guitarrista672f/graphite-system/iniciales backup/graphite_spireflows/kidkad_projects/project1/circuito_led/report.txt

Annotated +24V as #PWR01
Annotated GND as #PWR02
Annotated 400 as C1
Annotated LED as D1
Annotated 1000 as R1
Annotated L7805 as U1
