guitarrista672f/graphite-system/iniciales backup/arduino_grafito/arduino_graphite/arduino_graphite.jpg

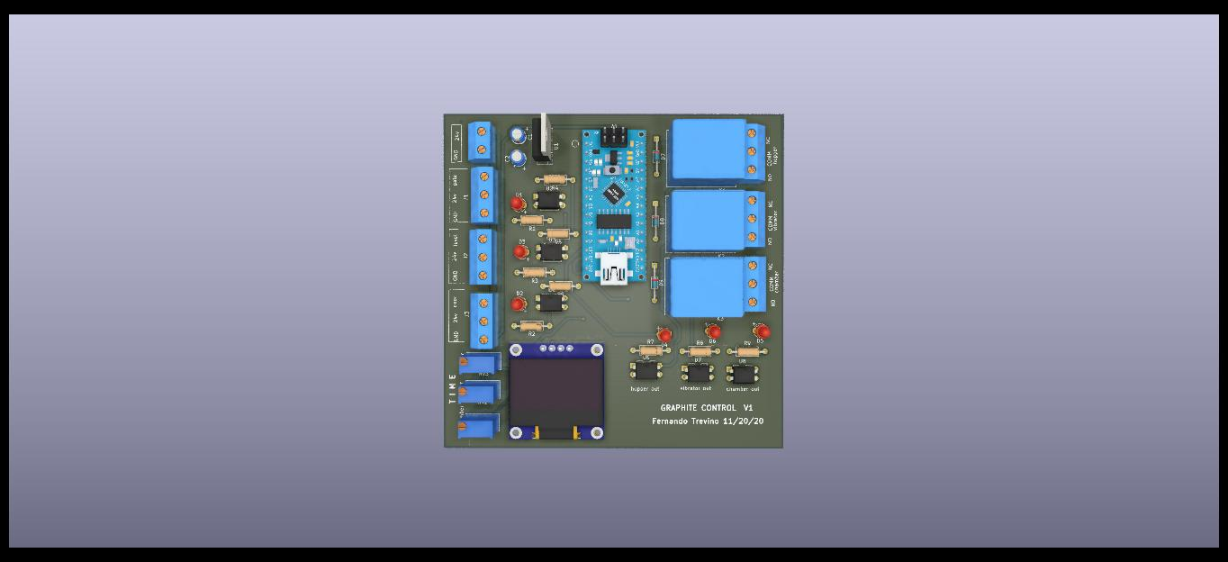
iniciales backup/arduino_grafito/arduino_graphite/arduino_graphite.jpg
