guitarrista672f/graphite-system/iniciales backup/graphite_spireflows/graphite pictures/20200905_205842.jpg

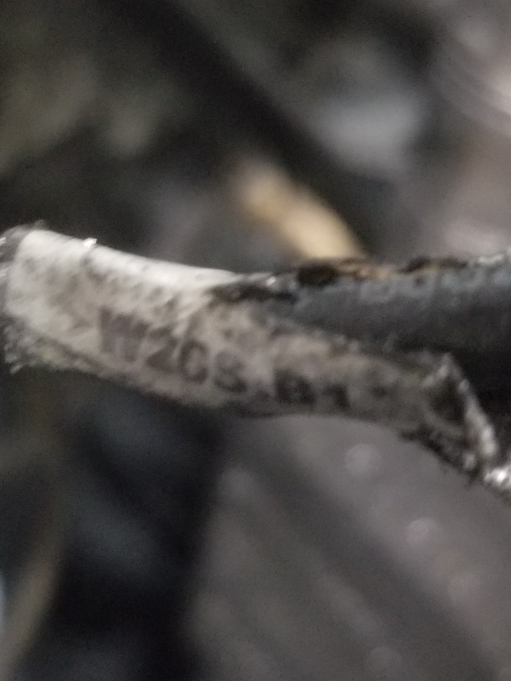
iniciales backup/graphite_spireflows/graphite pictures/20200905_205842.jpg
