guitarrista672f/graphite-system/iniciales backup/graphite_spireflows/graphite pictures/20201205_213206.jpg

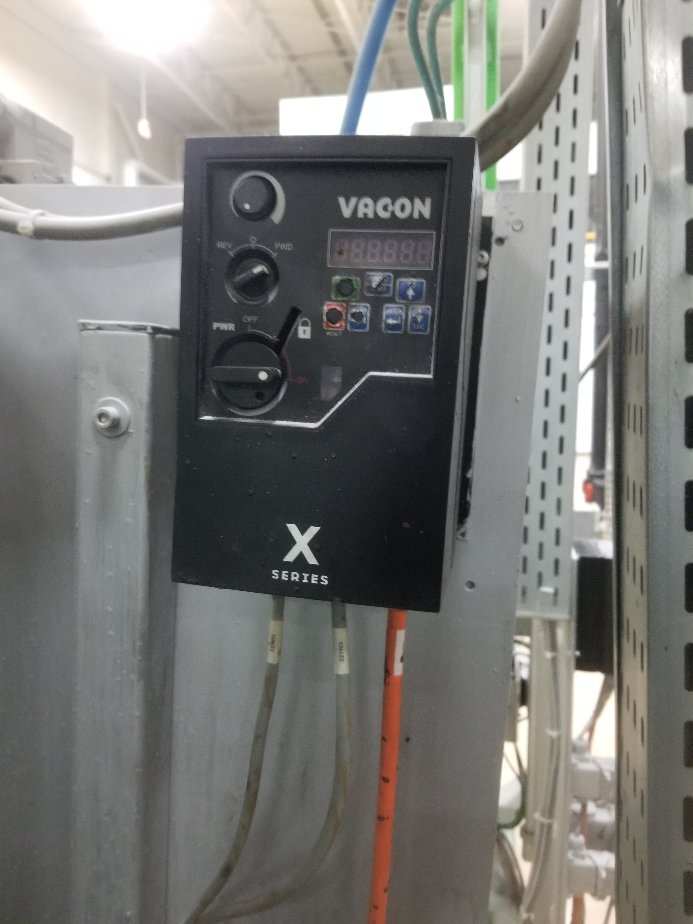
iniciales backup/graphite_spireflows/graphite pictures/20201205_213206.jpg
