guitarrista672f/graphite-system/iniciales backup/graphite_spireflows/graphite pictures/20201207_012839.jpg

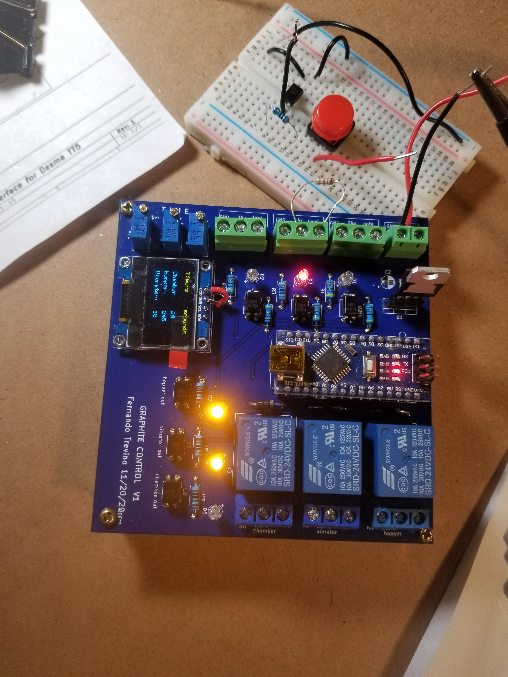
iniciales backup/graphite_spireflows/graphite pictures/20201207_012839.jpg
