guitarrista672f/graphite-system/iniciales backup/graphite_spireflows/graphite pictures/20201207_012943.jpg

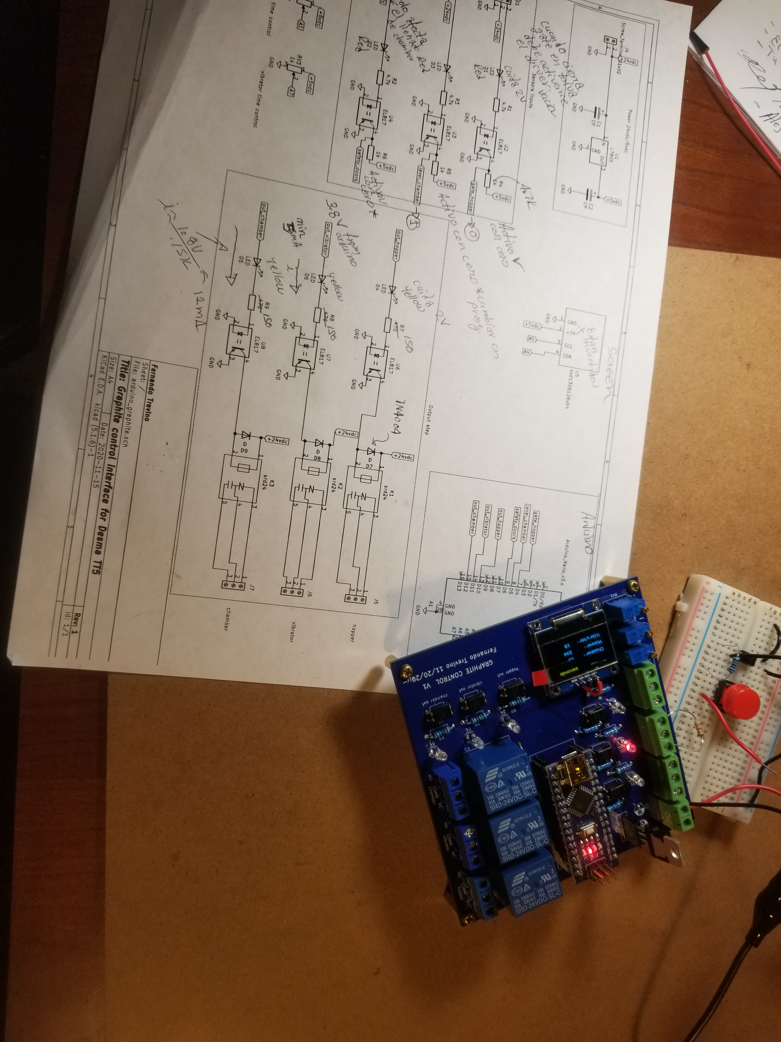
iniciales backup/graphite_spireflows/graphite pictures/20201207_012943.jpg
