guitarrista672f/graphite-system/iniciales backup/graphite_spireflows/graphite pictures/20201209_202442.jpg

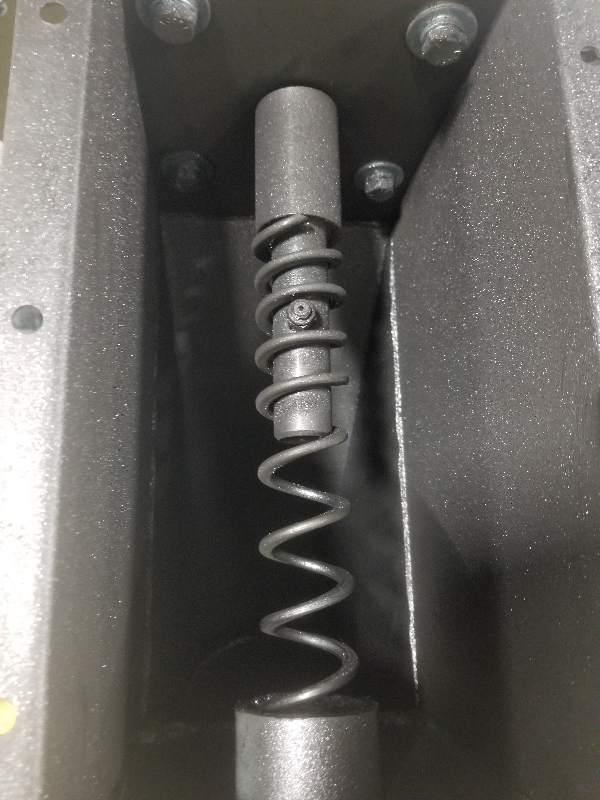
iniciales backup/graphite_spireflows/graphite pictures/20201209_202442.jpg
