guitarrista672f/graphite-system/iniciales backup/graphite_spireflows/graphite pictures/20201214_152126.jpg

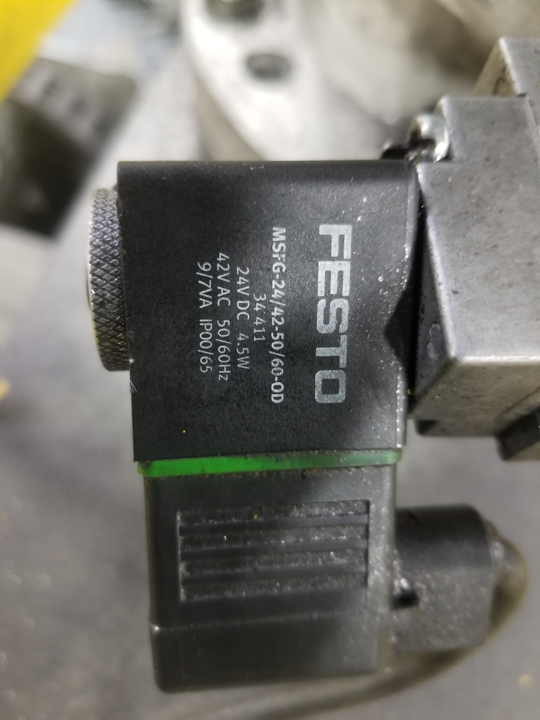
iniciales backup/graphite_spireflows/graphite pictures/20201214_152126.jpg
