guitarrista672f/graphite-system/iniciales backup/graphite_spireflows/graphite pictures/20201214_152921.jpg

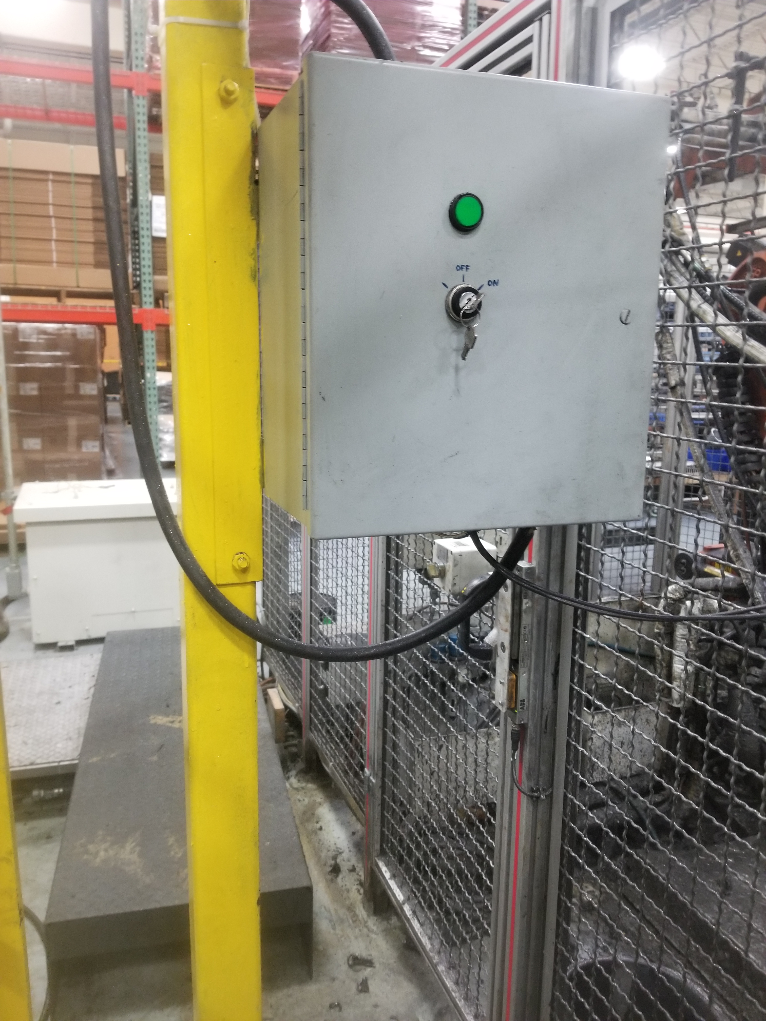
iniciales backup/graphite_spireflows/graphite pictures/20201214_152921.jpg
