guitarrista672f/graphite-system/iniciales backup/graphite_spireflows/graphite pictures/20201215_221558.jpg

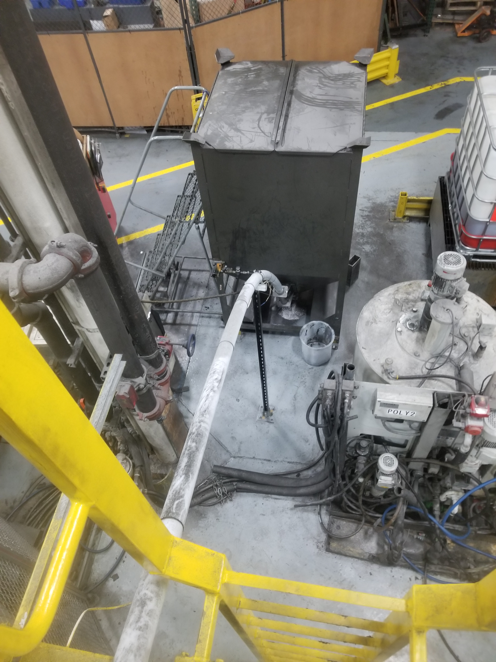
iniciales backup/graphite_spireflows/graphite pictures/20201215_221558.jpg
