guitarrista672f/graphite-system/iniciales backup/graphite_spireflows/control_digital_circuit_pcboard_disign/control_digital.kicad_pcb

## KiCad design iniciales backup/graphite_spireflows/control_digital_circuit_pcboard_disign/control_digital.kicad_pcb (2024-02-02)

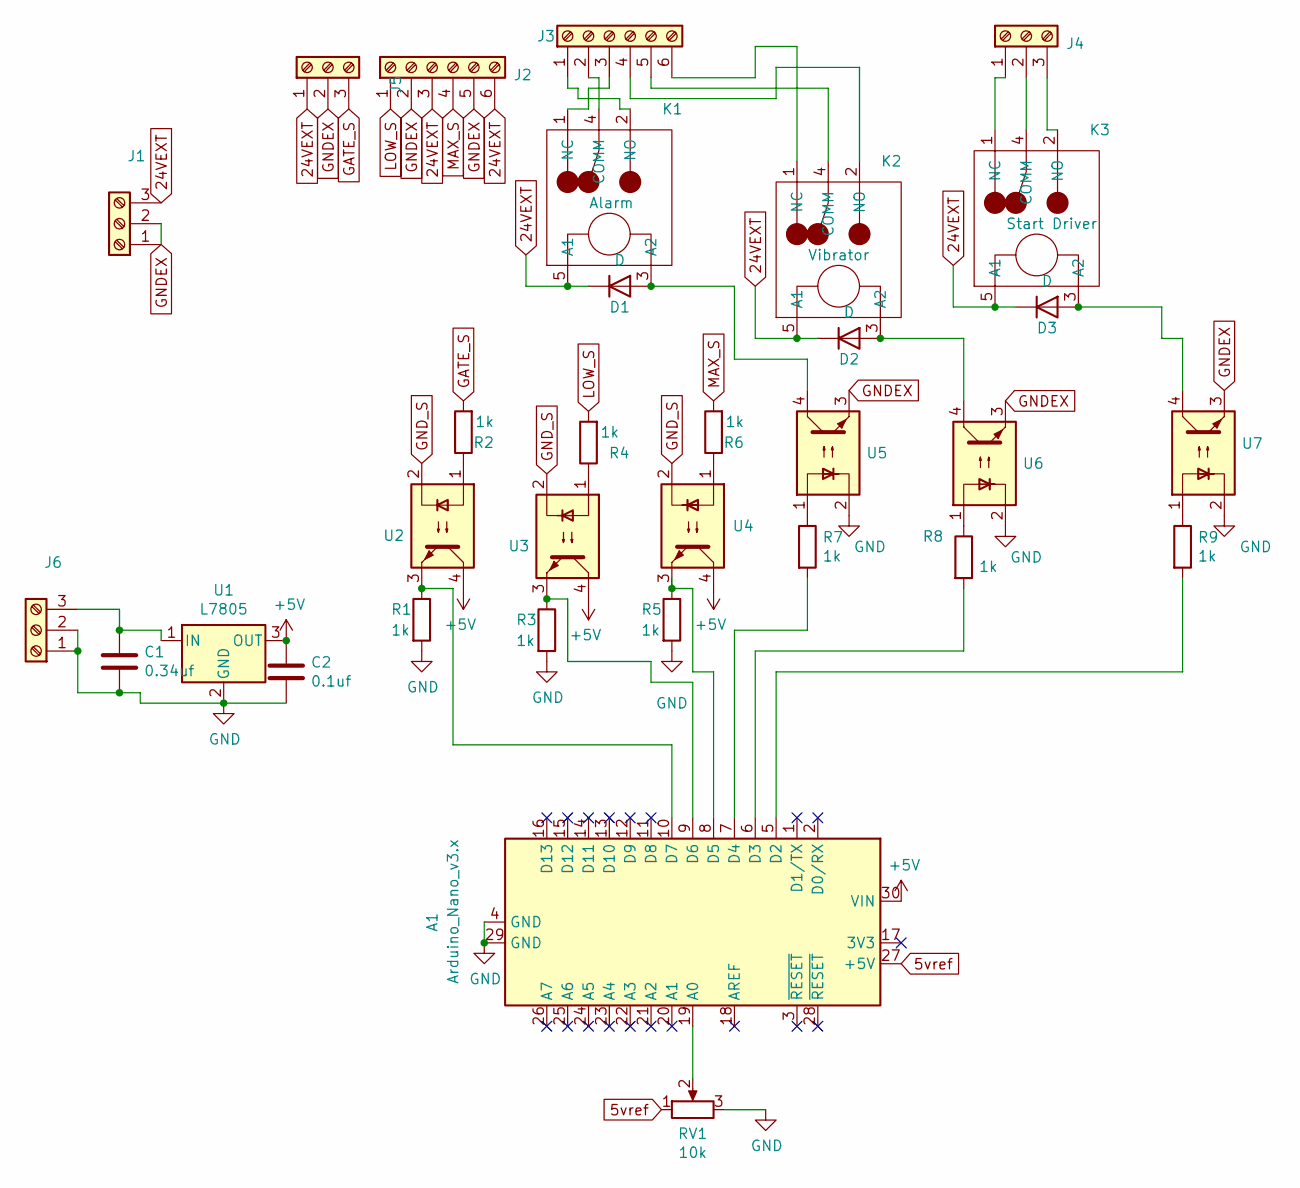
[picture p32: schematic control_digital.kicad_sch, Digital control for graphite system]

Parts:
A1: Arduino_Nano_v3.x; Arduino_Nano
C1: 0.34uf; CP_Radial_D6.3mm_P2.50mm
C2: 0.1uf; CP_Radial_D6.3mm_P2.50mm
D1, D2, D3: D; D_A-405_P7.62mm_Horizontal
J1, J4, J5, J6: Screw_Terminal_01x03; TerminalBlock_bornier-3_P5.08mm
J2, J3: Screw_Terminal_01x06; TerminalBlock_bornier-6_P5.08mm
K1: Alarm; SRD-24VDC-SL-C
K2: Vibrator; SRD-24VDC-SL-C
K3: Start Driver; SRD-24VDC-SL-C
R1, R2, R3, R4, R5, R6, R7, R8, R9: 1k; R_Axial_DIN0309_L9.0mm_D3.2mm_P12.70mm_Horizontal
RV1: 10k; pot_f
U1: L7805; Regulator7805
U2: SFH617A-2X016; DIP-4_W7.62mm
U3, U4, U5, U6, U7: SFH617A-2X016; DIP-4_W10.16mm

Connections:
5vref: A1.27 (+5V), RV1.1; also elsewhere on the board
24VEXT: D1.1 (K), D2.1 (K), D3.1 (K), J1.3, J2.3, J2.6, J5.1, K1.5 (A1), K2.5 (A1), K3.5 (A1)
+5V: A1.30 (VIN), C2.1, U1.3 (OUT), U2.4, U3.4, U4.4
GATE_S: J5.3, R2.2
GND: A1.4 (GND), A1.29 (GND), C1.2, C2.2, J6.1, J6.2, R1.2, R3.2, R5.2, RV1.3, U1.2 (GND), U5.2, U6.2, U7.2; also elsewhere on the board
GNDEX: J1.1, J1.2, J2.2, J2.5, J5.2, U5.3, U6.3, U7.3
GND_S: U2.2, U3.2, U4.2
LOW_S: J2.1, R4.2
MAX_S: J2.4, R6.2
unnamed: A1.5 (D2), R9.2
unnamed: A1.6 (D3), R8.2
unnamed: A1.7 (D4), R7.2
unnamed: A1.8 (D5), R5.1, U4.3
unnamed: A1.9 (D6), R3.1, U3.3
unnamed: A1.10 (D7), R1.1, U2.3
unnamed 15: A1.19 (A0), RV1.2; also elsewhere on the board
unnamed: C1.1, J6.3, U1.1 (IN)
unnamed: D1.2 (A), K1.3 (A2), U5.4
unnamed: D2.2 (A), K2.3 (A2), U6.4
unnamed: D3.2 (A), K3.3 (A2), U7.4
unnamed: J3.1, K1.2 (NO)
unnamed: J3.2, K1.4 (COMM)
unnamed: J3.3, K1.1 (NC)
unnamed: J3.4, K2.2 (NO)
unnamed: J3.5, K2.4 (COMM)
unnamed: J3.6, K2.1 (NC)
unnamed: J4.1, K3.1 (NC)
unnamed: J4.2, K3.4 (COMM)
unnamed: J4.3, K3.2 (NO)
unnamed: R2.1, U2.1
unnamed: R4.1, U3.1
unnamed: R6.1, U4.1
unnamed: R7.1, U5.1
unnamed: R8.1, U6.1
unnamed: R9.1, U7.1

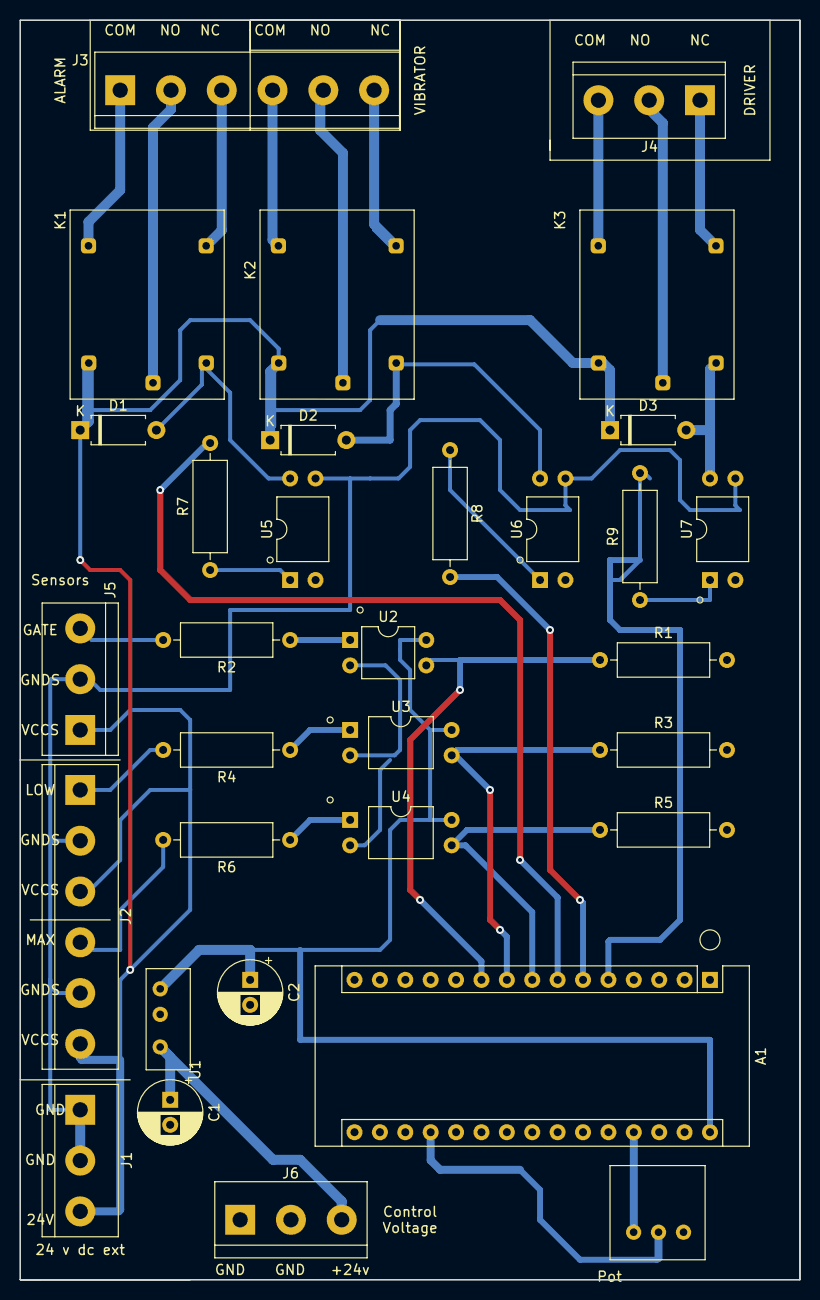
[picture p33: board control_digital.kicad_pcb from above]

Board: 2 copper layers, 78.0 x 126.0 mm, 32 parts (0 on the bottom side), 35 nets.

Other parts of the board:
Pot: 10k; pot_f

Their connections:
5vref: Pot.1; also elsewhere on the board
GND: Pot.3; also elsewhere on the board
unnamed 15: Pot.2; also elsewhere on the board
