guitarrista672f/graphite-system/iniciales backup/graphite_spireflows/kidkad_projects/project1/circuito_led/circuito_led.kicad_pcb

## KiCad design iniciales backup/graphite_spireflows/kidkad_projects/project1/circuito_led/circuito_led.kicad_pcb (2024-02-02)

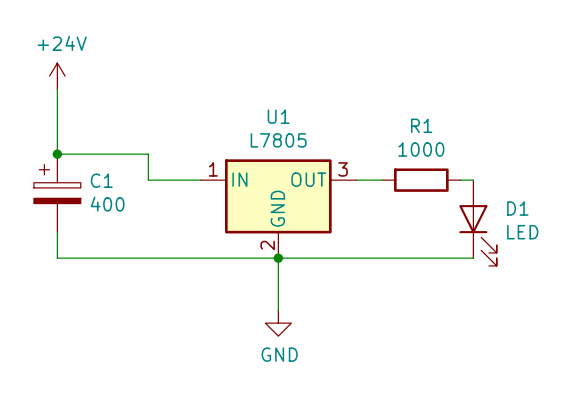
[picture p34: schematic circuito_led.sch]

Parts:
C1: 400; CP_Radial_D10.0mm_P3.50mm
D1: LED; LED_Oval_W5.2mm_H3.8mm
R1: 1000; R_Radial_Power_L16.1mm_W9.0mm_P7.37mm
U1: L7805; TO-220-3_Vertical

Connections:
+24V: C1.1, U1.1 (IN)
GND: C1.2, D1.1 (K), U1.2 (GND)
unnamed: D1.2 (A), R1.1
unnamed: R1.2, U1.3 (OUT)

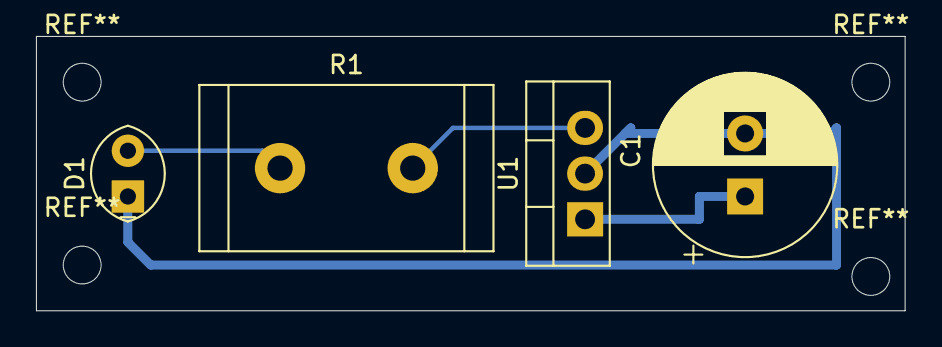
[picture p35: board circuito_led.kicad_pcb from above]

Board: 2 copper layers, 48.3 x 15.2 mm, 4 parts (0 on the bottom side), 4 nets.
