guitarrista672f/graphite-system/iniciales backup/arduino_grafito/arduino_graphite/arduino_graphite.kicad_pcb

## KiCad design iniciales backup/arduino_grafito/arduino_graphite/arduino_graphite.kicad_pcb (2024-02-02)

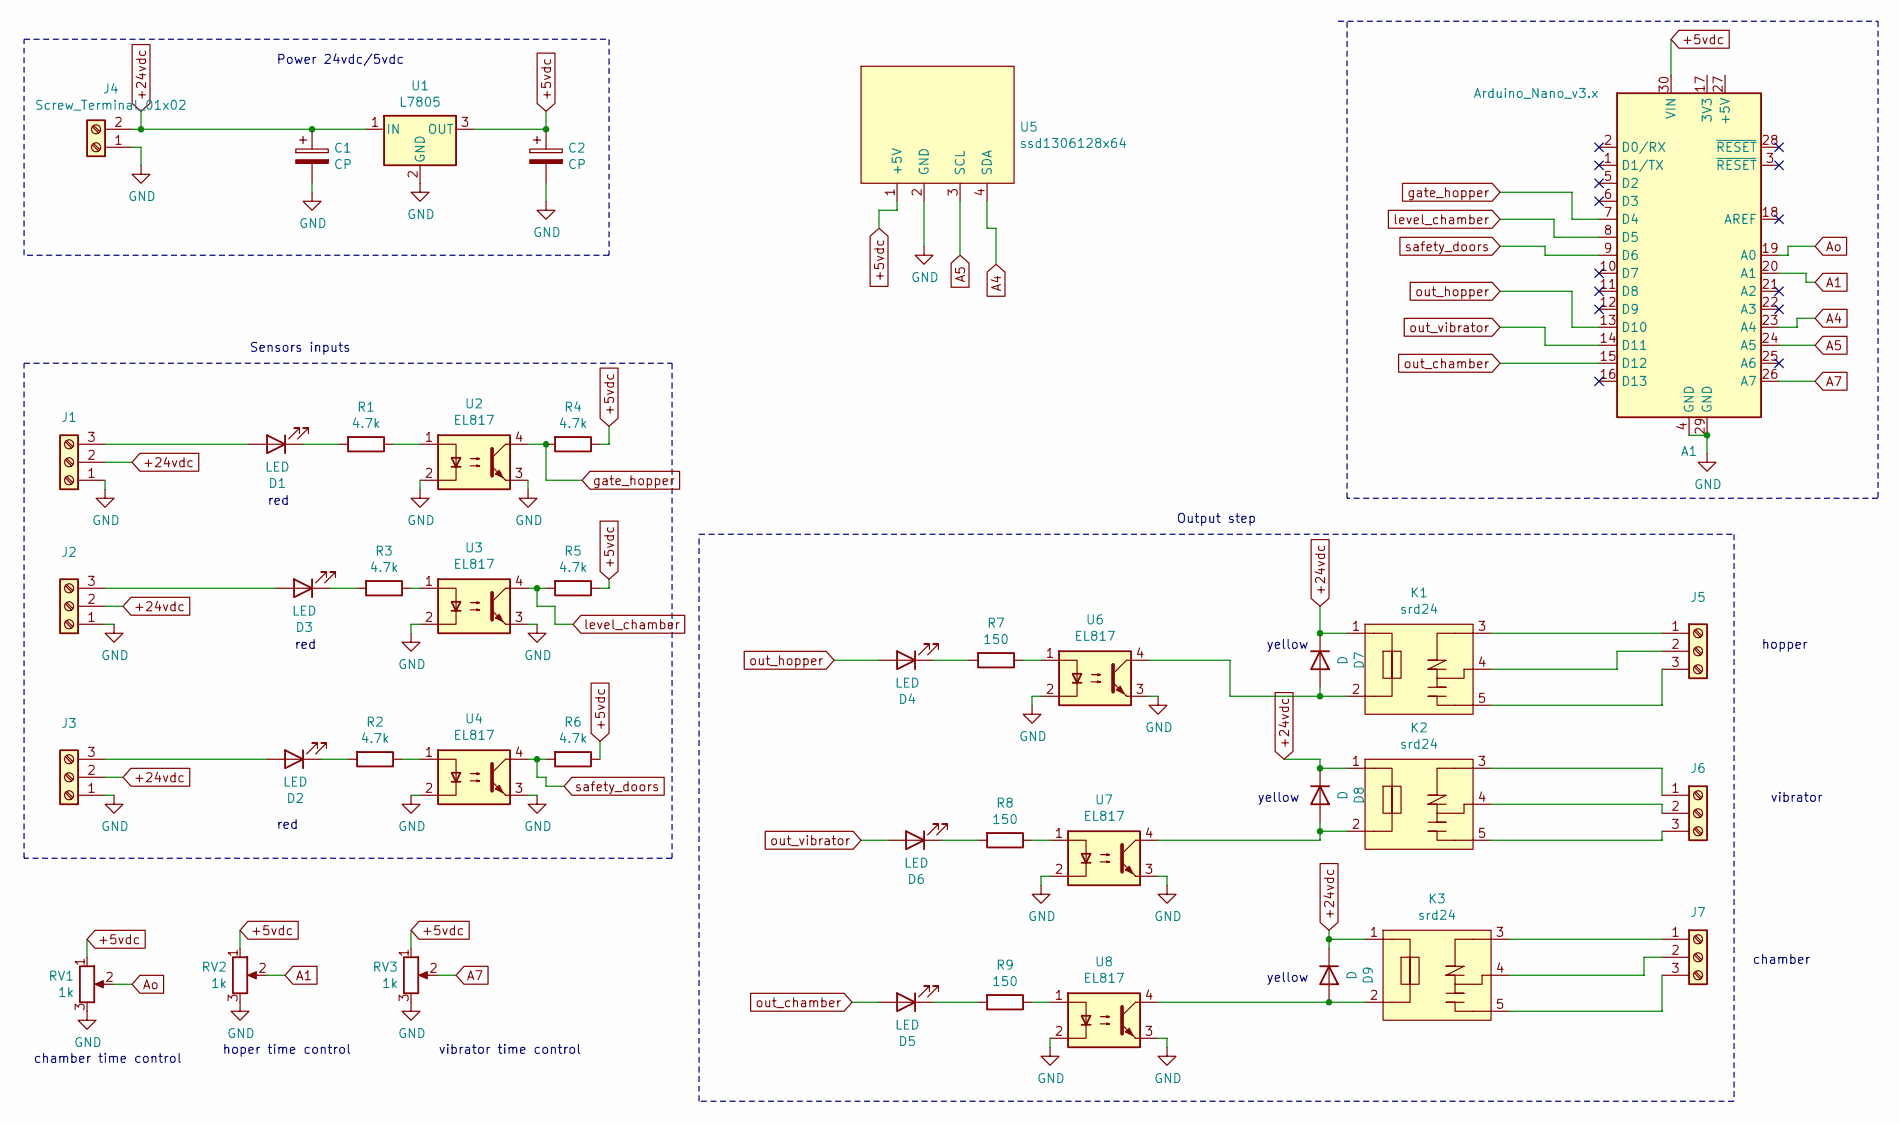
[picture p36: schematic arduino_graphite.sch, Graphite control interface for Desma TT5]

Parts:
A1: Arduino_Nano_v3.x; Arduino_Nano
C1, C2: CP; capacitor
D1, D2, D3, D4, D5, D6: LED; led
D7, D8, D9: D; diode
J1, J2, J3, J5, J6, J7: Screw_Terminal_01x03; TerminalBlock_Altech_AK300-3_P5.00mm
J4: Screw_Terminal_01x02; TerminalBlock_Altech_AK300-2_P5.00mm
K1, K2, K3: srd24
R1, R2, R3, R4, R5, R6: 4.7k; resistor
R7, R8, R9: 150; resistor
RV1, RV2, RV3: 1k; potensiometro
U1: L7805; 7805
U2, U3, U4, U6, U7, U8: EL817; DIP-4_W7.62mm
U5: ssd1306128x64

Connections:
+5vdc: A1.30 (VIN), C2.1, R4.1, R5.1, R6.1, RV1.1, RV2.1, RV3.1, U1.3 (OUT), U5.1 (+5V)
+24vdc: C1.1, D7.1 (K), D8.1 (K), D9.1 (K), J1.2, J2.2, J3.2, J4.2, K1.1, K2.1, K3.1, U1.1 (IN)
A1: A1.20 (A1), RV2.2
A4: A1.23 (A4), U5.4 (SDA)
A5: A1.24 (A5), U5.3 (SCL)
A7: A1.26 (A7), RV3.2
Ao: A1.19 (A0), RV1.2
GND: A1.4 (GND), A1.29 (GND), C1.2, C2.2, J1.1, J2.1, J3.1, J4.1, RV1.3, RV2.3, RV3.3, U1.2 (GND), U2.2, U2.3, U3.2, U3.3, U4.2, U4.3, U5.2 (GND), U6.2, U6.3, U7.2, U7.3, U8.2, U8.3
unnamed: D1.1 (K), R1.2
unnamed: D1.2 (A), J1.3
unnamed: D2.1 (K), R2.2
unnamed: D2.2 (A), J3.3
unnamed: D3.1 (K), R3.2
unnamed: D3.2 (A), J2.3
unnamed: D4.1 (K), R7.2
unnamed: D5.1 (K), R9.2
unnamed: D6.1 (K), R8.2
unnamed: D7.2 (A), K1.2, U6.4
unnamed: D8.2 (A), K2.2, U7.4
unnamed: D9.2 (A), K3.2, U8.4
unnamed: J5.1, K1.3
unnamed: J5.2, K1.4
unnamed: J5.3, K1.5
unnamed: J6.1, K2.3
unnamed: J6.2, K2.4
unnamed: J6.3, K2.5
unnamed: J7.1, K3.3
unnamed: J7.2, K3.4
unnamed: J7.3, K3.5
unnamed: R1.1, U2.1
unnamed: R2.1, U4.1
unnamed: R3.1, U3.1
unnamed: R7.1, U6.1
unnamed: R8.1, U7.1
unnamed: R9.1, U8.1
gate_hopper: A1.7 (D4), R4.2, U2.4
level_chamber: A1.8 (D5), R5.2, U3.4
out_chamber: A1.15 (D12), D5.2 (A)
out_hopper: A1.13 (D10), D4.2 (A)
out_vibrator: A1.14 (D11), D6.2 (A)
safety_doors: A1.9 (D6), R6.2, U4.4

Notes on the sheet:
Output step
Power 24vdc/5vdc
Sensors inputs
hopper
vibrator
chamber
chamber time control
hoper time control
vibrator time control
yellow
red

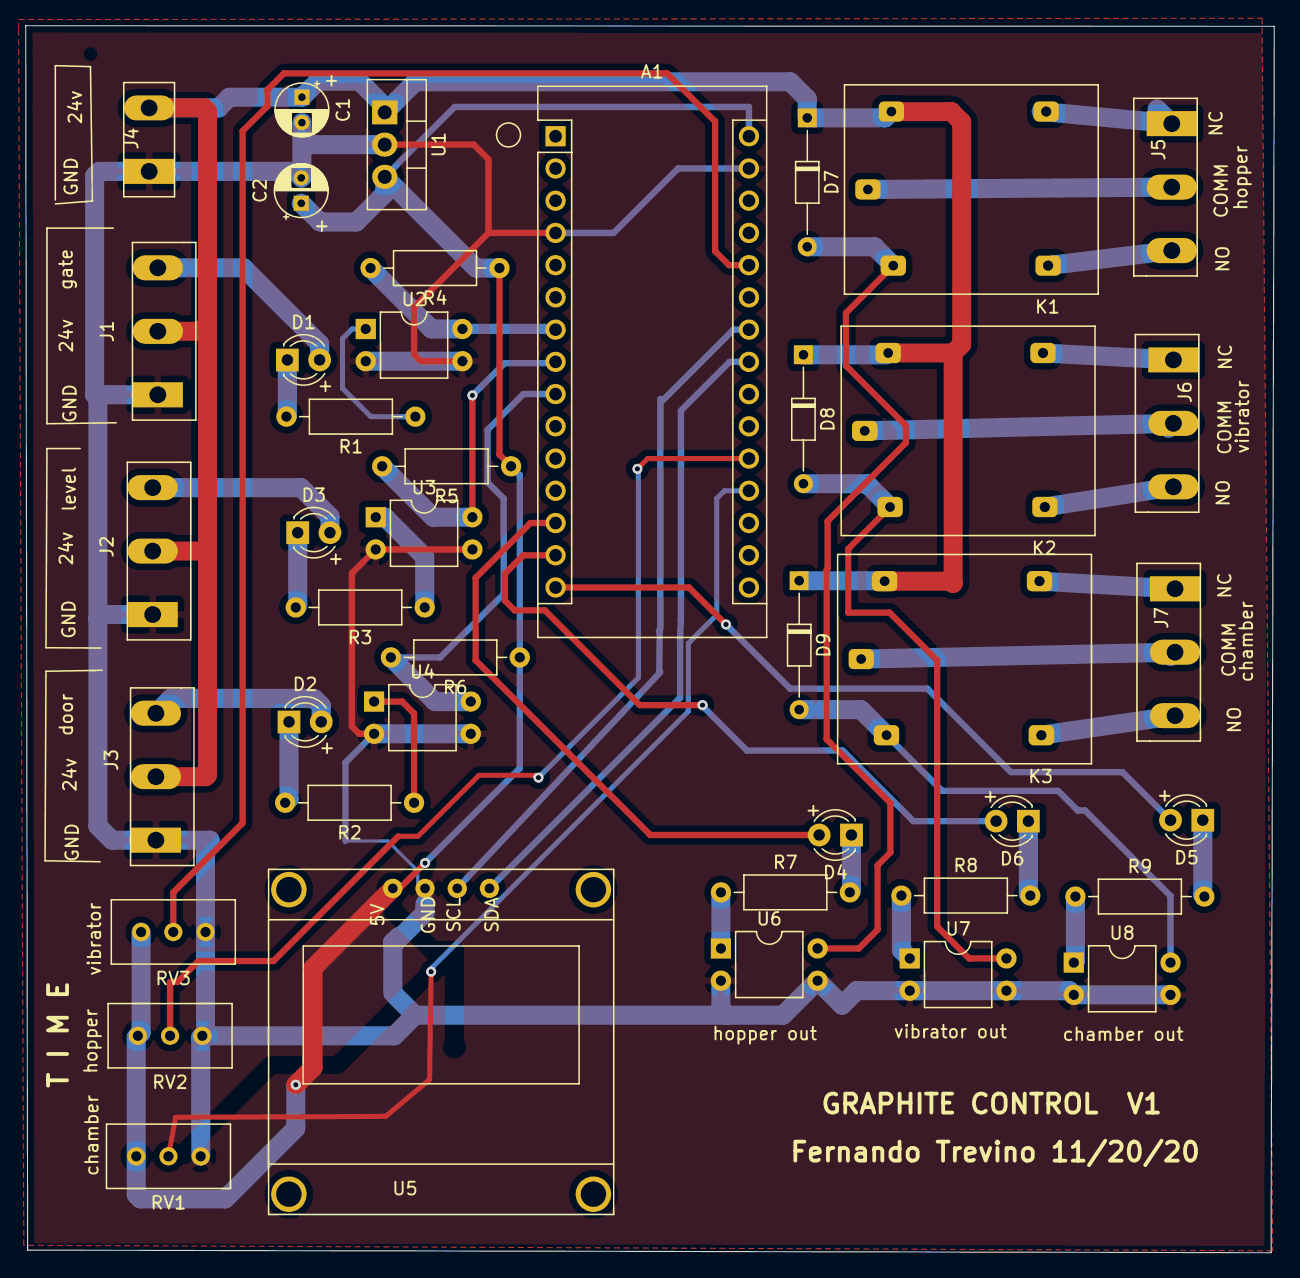
[picture p37: board arduino_graphite.kicad_pcb from above]

Board: 2 copper layers, 98.4 x 96.7 mm, 42 parts (0 on the bottom side), 41 nets.
