guitarrista672f/graphite-system/iniciales backup/graphite_spireflows/kidkad_projects/557/557_circuit/557_circuit.kicad_pcb

## KiCad design iniciales backup/graphite_spireflows/kidkad_projects/557/557_circuit/557_circuit.kicad_pcb (2024-02-02)

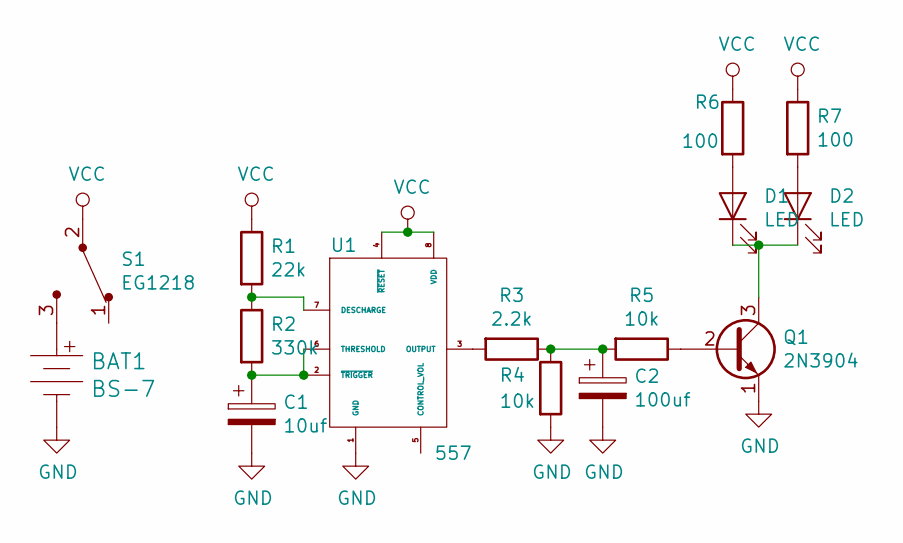
[picture p38: schematic 557_circuit.sch, 555]

Parts:
BAT1: BS-7; Battery_Holder_Coin_2032_BS-7; MPN BS-7; Digi-Key_PN BS-7-ND
C1: 10uf; CP_Radial_D4.0mm_P1.50mm
C2: 100uf; CP_Radial_D4.0mm_P1.50mm
D1, D2: LED; LED_D1.8mm_W3.3mm_H2.4mm
Q1: 2N3904; TO-92_Inline
R1: 22k; R_Axial_DIN0309_L9.0mm_D3.2mm_P20.32mm_Horizontal
R2: 330k; R_Axial_DIN0309_L9.0mm_D3.2mm_P20.32mm_Horizontal
R3: 2.2k; R_Axial_DIN0309_L9.0mm_D3.2mm_P20.32mm_Horizontal
R4, R5: 10k; R_Axial_DIN0309_L9.0mm_D3.2mm_P20.32mm_Horizontal
R6, R7: 100; R_Axial_DIN0309_L9.0mm_D3.2mm_P20.32mm_Horizontal
S1: EG1218; Switch_Slide_11.6x4mm_EG1218; MPN EG1218; Digi-Key_PN EG1903-ND
U1: 557; ICM7555-PDIP

Connections:
GND: BAT1.Neg, C1.2, C2.2, Q1.1 (E), R4.2, U1.1 (GND)
unnamed: BAT1.Pos, S1.3
unnamed: C1.1, R2.2, U1.2 (~TRIGGER), U1.6 (THRESHOLD)
unnamed: C2.1, R3.1, R4.1, R5.2
unnamed: D1.1 (K), D2.1 (K), Q1.3 (C)
unnamed: D1.2 (A), R6.2
unnamed: D2.2 (A), R7.2
unnamed: Q1.2 (B), R5.1
unnamed: R1.2, R2.1, U1.7 (DESCHARGE)
unnamed: R3.2, U1.3 (OUTPUT)
VCC: R1.1, R6.1, R7.1, S1.2, U1.4 (~RESET), U1.8 (VDD)

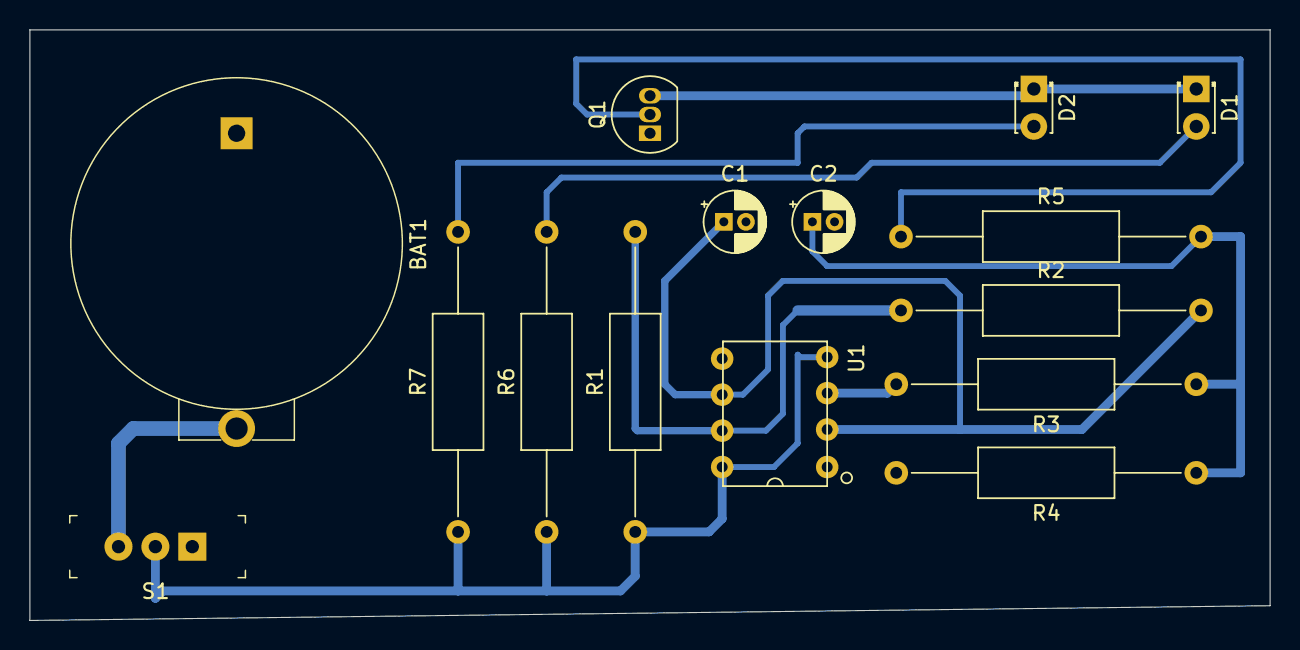
[picture p39: board 557_circuit.kicad_pcb from above]

Board: 2 copper layers, 84.0 x 40.0 mm, 15 parts (0 on the bottom side), 11 nets.
