guitarrista672f/graphite-system/iniciales backup/graphite_spireflows/kidkad_projects/project1/Arduino_Nano/ArduinoNano/ArduinoNano.kicad_pcb

## KiCad design iniciales backup/graphite_spireflows/kidkad_projects/project1/Arduino_Nano/ArduinoNano/ArduinoNano.kicad_pcb (2024-02-02)

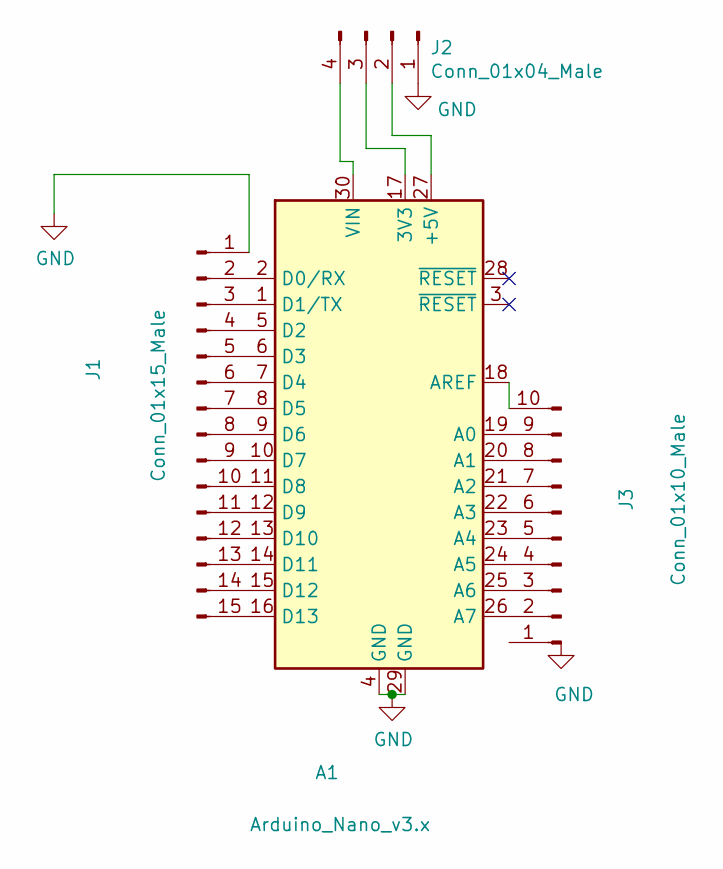
[picture p40: schematic ArduinoNano.sch, Arduino Nano PCB]

Parts:
A1: Arduino_Nano_v3.x; Arduino_Nano_WithMountingHoles
J1: Conn_01x15_Male; PinHeader_1x15_P2.54mm_Vertical
J2: Conn_01x04_Male; PinHeader_1x04_P2.54mm_Vertical
J3: Conn_01x10_Male; PinHeader_1x10_P2.54mm_Vertical

Connections:
GND: A1.4 (GND), A1.29 (GND), J1.1, J2.1
unnamed: A1.1 (D1/TX), J1.3
unnamed: A1.2 (D0/RX), J1.2
unnamed: A1.5 (D2), J1.4
unnamed: A1.6 (D3), J1.5
unnamed: A1.7 (D4), J1.6
unnamed: A1.8 (D5), J1.7
unnamed: A1.9 (D6), J1.8
unnamed: A1.10 (D7), J1.9
unnamed: A1.11 (D8), J1.10
unnamed: A1.12 (D9), J1.11
unnamed: A1.13 (D10), J1.12
unnamed: A1.14 (D11), J1.13
unnamed: A1.15 (D12), J1.14
unnamed: A1.16 (D13), J1.15
unnamed: A1.17 (3V3), J2.3
unnamed: A1.18 (AREF), J3.10
unnamed: A1.19 (A0), J3.9
unnamed: A1.20 (A1), J3.8
unnamed: A1.21 (A2), J3.7
unnamed: A1.22 (A3), J3.6
unnamed: A1.23 (A4), J3.5
unnamed: A1.24 (A5), J3.4
unnamed: A1.25 (A6), J3.3
unnamed: A1.26 (A7), J3.2
unnamed: A1.27 (+5V), J2.2
unnamed: A1.30 (VIN), J2.4

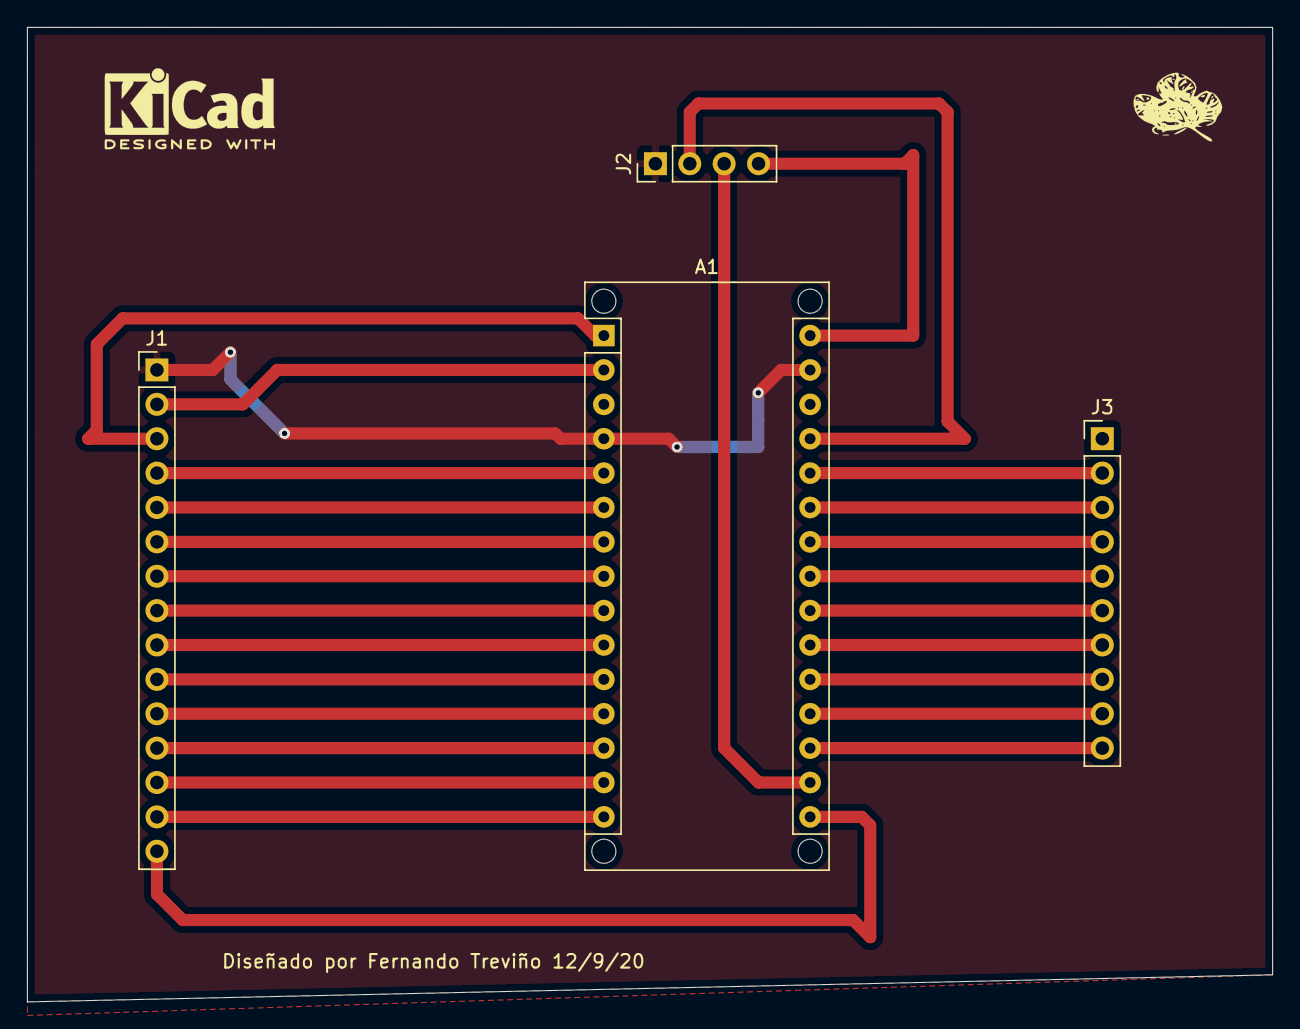
[picture p41: board ArduinoNano.kicad_pcb from above]

Board: 2 copper layers, 92.0 x 72.0 mm, 5 parts (0 on the bottom side), 27 nets.

Other parts of the board:
ft: fam1; logo
