guitarrista672f/graphite-system/iniciales backup/graphite_spireflows/graphite pictures/20201202_225114.jpg

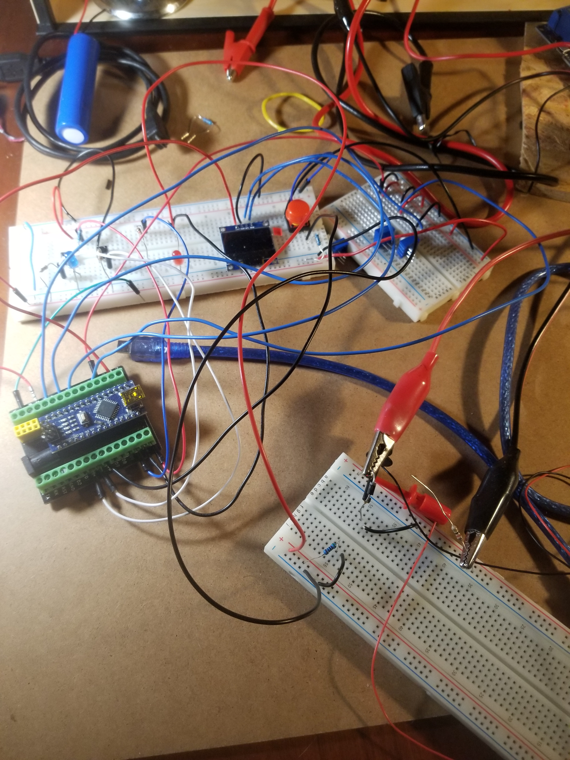
iniciales backup/graphite_spireflows/graphite pictures/20201202_225114.jpg
