guitarrista672f/graphite-system/iniciales backup/graphite_spireflows/graphite pictures/20201203_215249.jpg

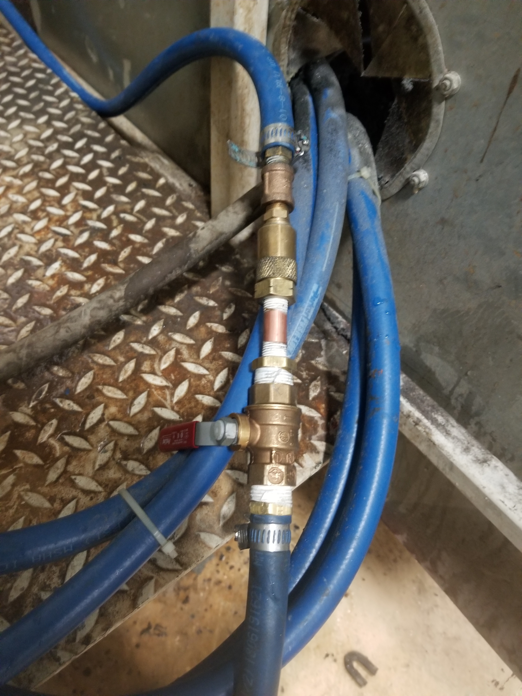
iniciales backup/graphite_spireflows/graphite pictures/20201203_215249.jpg
