guitarrista672f/graphite-system/iniciales backup/graphite_spireflows/graphite pictures/20201215_221411.jpg

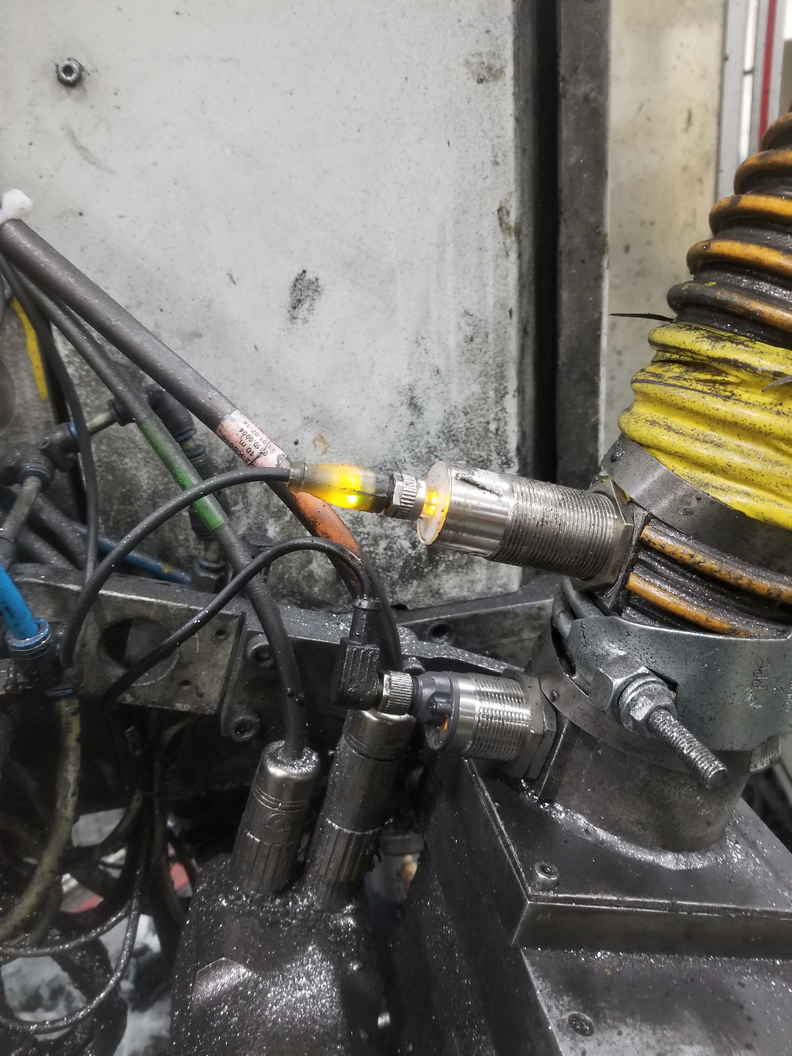
iniciales backup/graphite_spireflows/graphite pictures/20201215_221411.jpg
