guitarrista672f/graphite-system/iniciales backup/graphite_spireflows/graphite pictures/20201215_221531.jpg

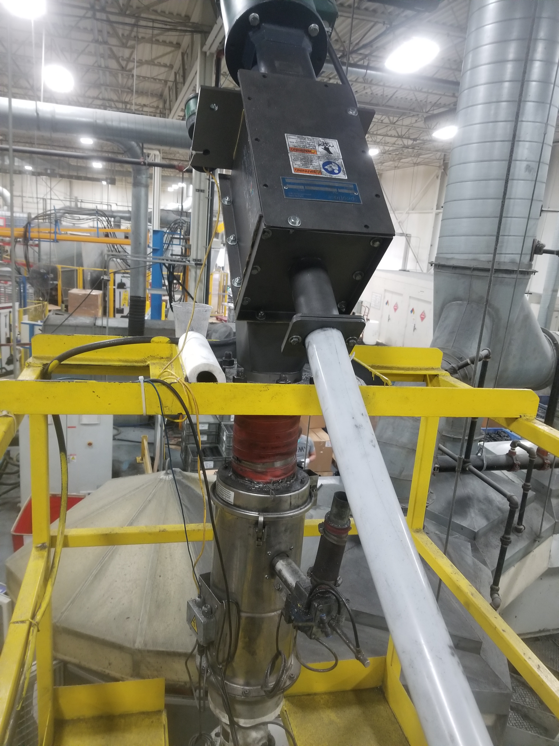
iniciales backup/graphite_spireflows/graphite pictures/20201215_221531.jpg
